HexabitzPlatform/H17R1x-Hardware/README.md

# H17R1x-Hardware
Hexabitz 10A(RMS)/85V Stepper Drive Module Hardware Design
