HexabitzPlatform/H17R1x-Hardware/H17R10/Released/BOM/H17R10.xlsx

 |  | www.hexabitz.com info@hexabitz.com |  |  | Bill Of Materials
Customer | Hexabitz | Revision | 0
Project | Hexabitz Modules | Date | 2023-05-09
Board | Stepper motor driver Module (H17R10) | Notes
Designator | Description | Manufacturer Part Number | Manufacturer | Octopart Url | Quantity
A, B, PWR | Block, Terminal; 13.5 A; 250 V; 5 mm; 26 to 16 AWG; 2; Screw; Solder; 4 kV; PA | Phoenix Contact | 1729018 | https://octopart.com/1729018-phoenix+contact-8551?r=sp | 3
R | PCB Header, Unshrouded, Thru 02 Straight Header, .101, AMPMODU Mod II Series | 87227-1 | TE Connectivity | https://octopart.com/87227-1-te+connectivity-39512052?r=sp | 1
SWD | Conn Unshrouded Header HDR 3 POS 2.54mm Solder ST Top Entry Thru-Hole Carton | 5-146281-3 | TE Connectivity | https://octopart.com/5-146281-3-te+connectivity+%2F+amp-39745942?r=sp | 1
EMG_SW | 2 Position Total Single Row 2.54 mm Pitch Straight Male Thru-Hole Header | M20-9990245 | HARWIN INC | https://octopart.com/m20-9990245-harwin-7492269?r=sp | 1
R1 | RES SMD 0.0OHM JUMPER 1/10W 0603 | RC0603JR-070RL | YAGEO [VR] | https://octopart.com/rc0603jr-070rl-yageo-1241539?r=sp | 1
R4, R6, R19, R20, R21, R22 | RES 0.1 OHM 1% 2W 2512 | PE2512FKE7W0R1L | YAGEO | https://octopart.com/pe2512fke7w0r1l-yageo-71384148?r=sp | 6
R2 | Thick Film Resistors - SMD 0603 270 Ohm 5% Tol | ERJ-3GEYJ271V | Panasonic | https://octopart.com/erj-3geyj271v-panasonic-55560546?r=sp | 1
R11, R15 | RES 330 OHM 5% 1/10W 0603 | RC0603JR-07330RL | YAGEO | https://octopart.com/rc0603jr-07330rl-yageo-39803615?r=sp | 2
R16 | Res Thick Film 0603 1K Ohm 5% 1/10W ±100ppm/°C | RC0603JR-071KL | YAGEO [VR] | https://octopart.com/rc0603jr-071kl-yageo-55402888?r=sp | 1
R18 | RES SMD 2K OHM 1% 1/10W 0603 | CRCW06032K00FKEA | Vishay Dale | https://octopart.com/crcw06032k00fkea-vishay-39455515?r=sp | 1
R3 | RES 10K Ohm 5% 0603 | CRCW060310K0JNEB | Vishay | https://octopart.com/crcw060310k0jneb-vishay-46603269 | 1
R7, R8, R9, R10 | RES 10K OHM 1% 1/8W 0805 | RC0805FR-0710KL | Panasonic | https://octopart.com/rc0805fr-0710kl-yageo-40301103?r=sp | 4
R5, R13, R14 | RES 39K OHM 1% 1/10W 0603 | RC0603FR-0739KL | Yageo | https://octopart.com/rc0603fr-0739kl-yageo-55402883?r=sp | 3
R17 | RES SMD 100K OHM 1% 1/10W 0603 | CRCW0603100KFKEA | Vishay Dale | https://octopart.com/crcw0603100kfkea-vishay-39670900?r=sp | 1
C15 | CAP CER 0.047UF 100V X7R 0805 | C0805C473K1RACTU | KEMET | https://octopart.com/c0805c473k1ractu-kemet-12557765?r=sp | 1
C1 ,C2, C4, C6, C8,C16, C17,C22 ,C23 | CAP CER 0.1 UF 10% X7R 0603 | C0603C104K8RACTU | KEMET | https://octopart.com/c0603c104k8ractu-kemet-145075?r=sp&s=9bS9ASSwSEqMCE9KBEQZ0g | 9
C11, C12, C13, C14 | CAP CER 0.22UF 100V X7R 0805 | C0805C224K1RAC7800 | KEMET | https://octopart.com/c0805c224k1ractu-kemet-12818106?r=sp | 4
C19 | CAP CER 0.22UF 16V X7R 0603 | CC0603KRX7R7BB224 | Yageo | https://octopart.com/cc0603krx7r7bb224-yageo-6827757?r=sp | 1
C18 , C20 | CAP CER 0.47UF 16V X5R 0603 | C1608X5R1C474K080AA | TDK CORPORATION | https://octopart.com/c1608x5r1c474k080aa-tdk-25947642?r=sp | 2
C5 | CAP CER 1 UF 16V X7R 0805 | CC0805KKX7R7BB105 | YAGEO [VA] | https://octopart.com/cc0805kkx7r7bb105-yageo-8376555?r=sp | 1
C7 , C3 | CAP TANT 4.7 UF 10V 20% 0805 | 10TPU4R7MSI | Panasonic | https://octopart.com/10tpu4r7msi-panasonic-29487748?r=sp | 2
C21 | CAP TANT 22UF 10% 6.3V 1206 | T491A226K006AT | KEMET | https://octopart.com/t491a226k006at-kemet-968601?r=sp | 1
C9 , C10 | CAP ALUM 68UF 20% 100V SMD | EMVY101ARA680MKE0S | United Chemi-Con | https://octopart.com/emvy101ara680mke0s-united+chemi-con-205274?r=sp | 2
FB1 | Ind chip Bead Multi-Layer 30 ohms 25% 100MHZ Ferrite 1,5A 0603Punched paper T/R | MMZ1608Y300BTA00 | TDK | https://octopart.com/mmz1608y300bta00-tdk-7906990?r=sp | 1
D1 , D8 | Red 0603 130° Clear 54 mcd 2 V Surface Mount ChipLED | VLMS1300-GS08 | Vishay | https://octopart.com/vlms1300-gs08-vishay-21709201?r=sp&s=0nXJNjGsSbWwqfqWlZv0EA | 2
D3, D5, D6, D7, D10 | LED Uni-Color Yellow 588nm 2-Pin Chip 0603(1608Metric) T/R | VLMY1300-GS08 | VISHAY | https://octopart.com/vlmy1300-gs08-vishay-21709204?r=sp | 5
D4 | DIODE ARRAY SCHOTTKY 30V SOT23-3 | BAT54SLT1G | ONSEMI | https://octopart.com/bat54slt1g-onsemi-21401?r=sp | 1
D2 | DIODE SCHOTTKY 100V 150MA SOD123 | BAT46ZFILM | STMicroelectronics | https://octopart.com/bat46zfilm-stmicroelectronics-658190?r=sp | 1
U1 | MCU 32-Bit ARM Cortex-M0+ RISC 512kByte Flash 1.7V to 3.6V 48-Pin UFQFPN Tray | STM32G0B1CEU6N | STMicroelectronics | https://octopart.com/stm32g0b1ceu6n-stmicroelectronics-116364672?r=sp | 1
U2 | Bipolar Stepper Motor Driver 7.5V to 85V 11-Pin VFQFPN Tray | POWERSTEP01 | STMicroelectronics | https://octopart.com/powerstep01-stmicroelectronics-30554993?r=sp | 1
X1 | 8,0000MHZ 33pF SMD MURATA Resonators | CSTNE8M00G550000R0 | Murata | https://octopart.com/cstne8m00g550000r0-murata-91406934?r=sp | 1
