HexabitzPlatform/H17R1x-Hardware/H17R10/documentation/H17R10.pdf

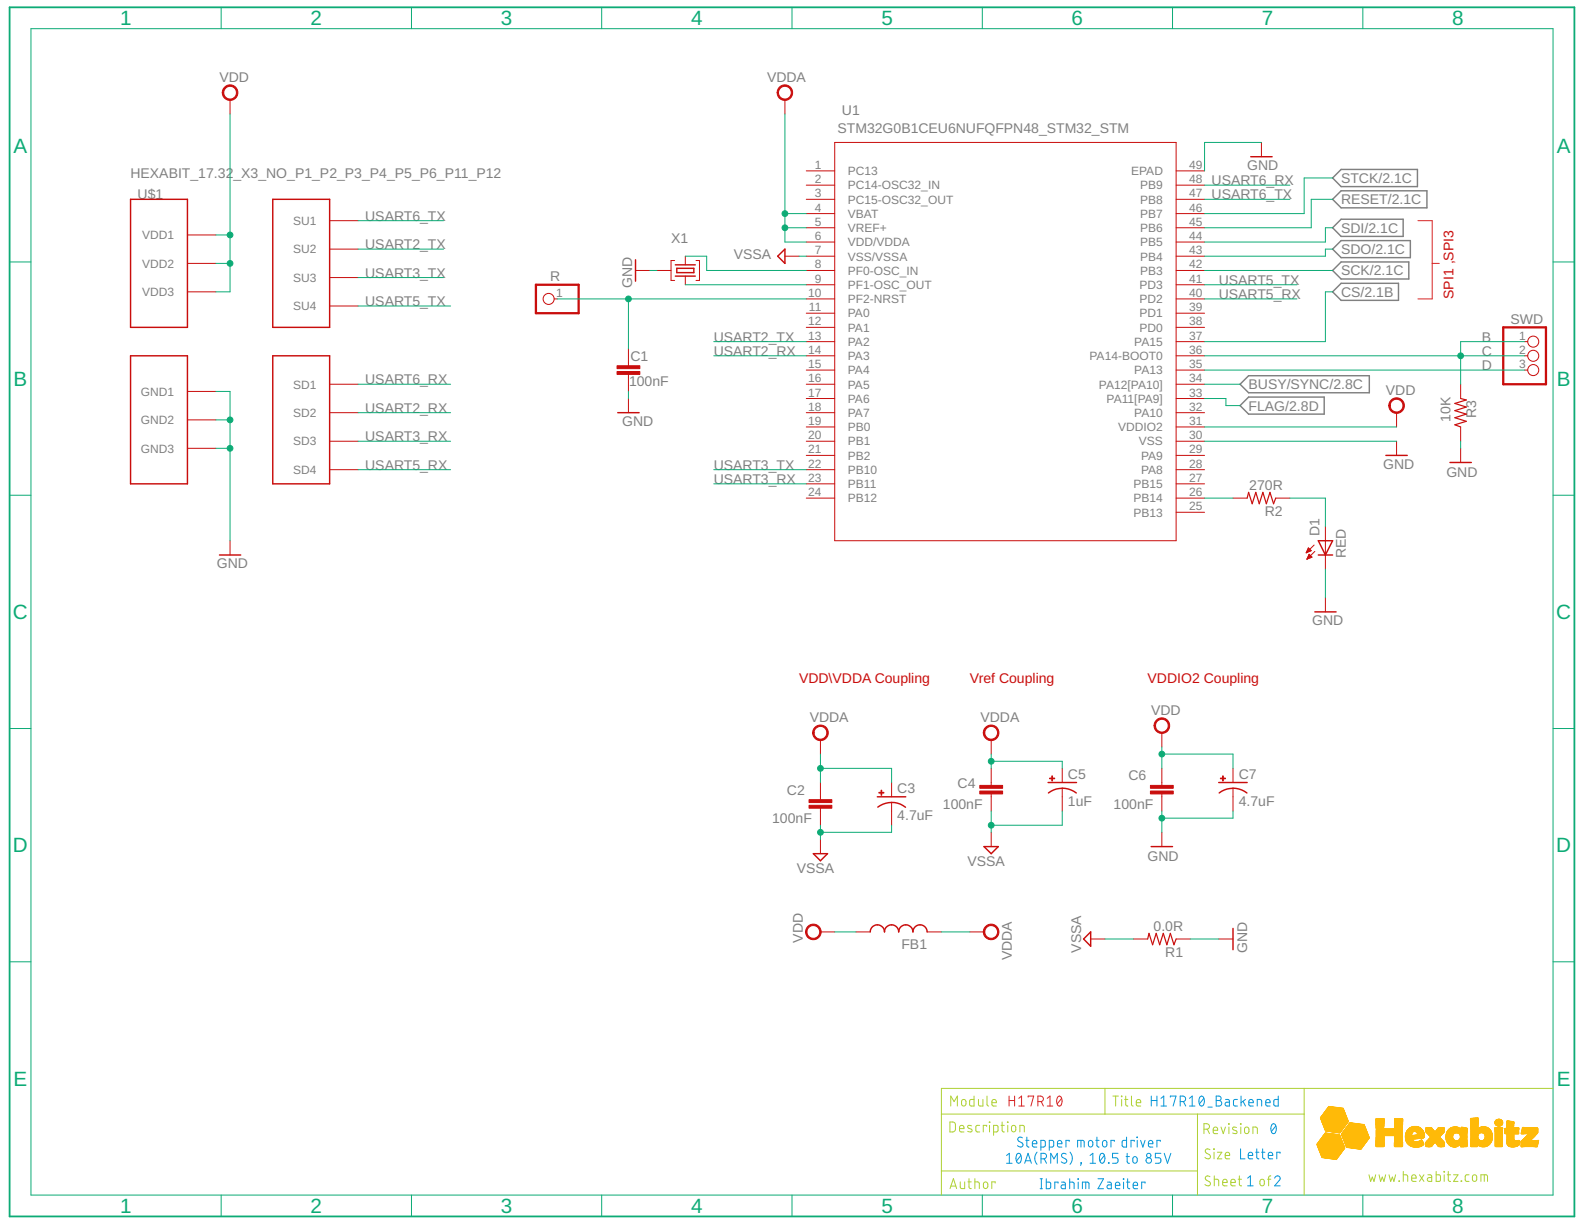
[picture p1: page 1]

VDDA

5 | | 45 PB7
6 | | 44 PB6

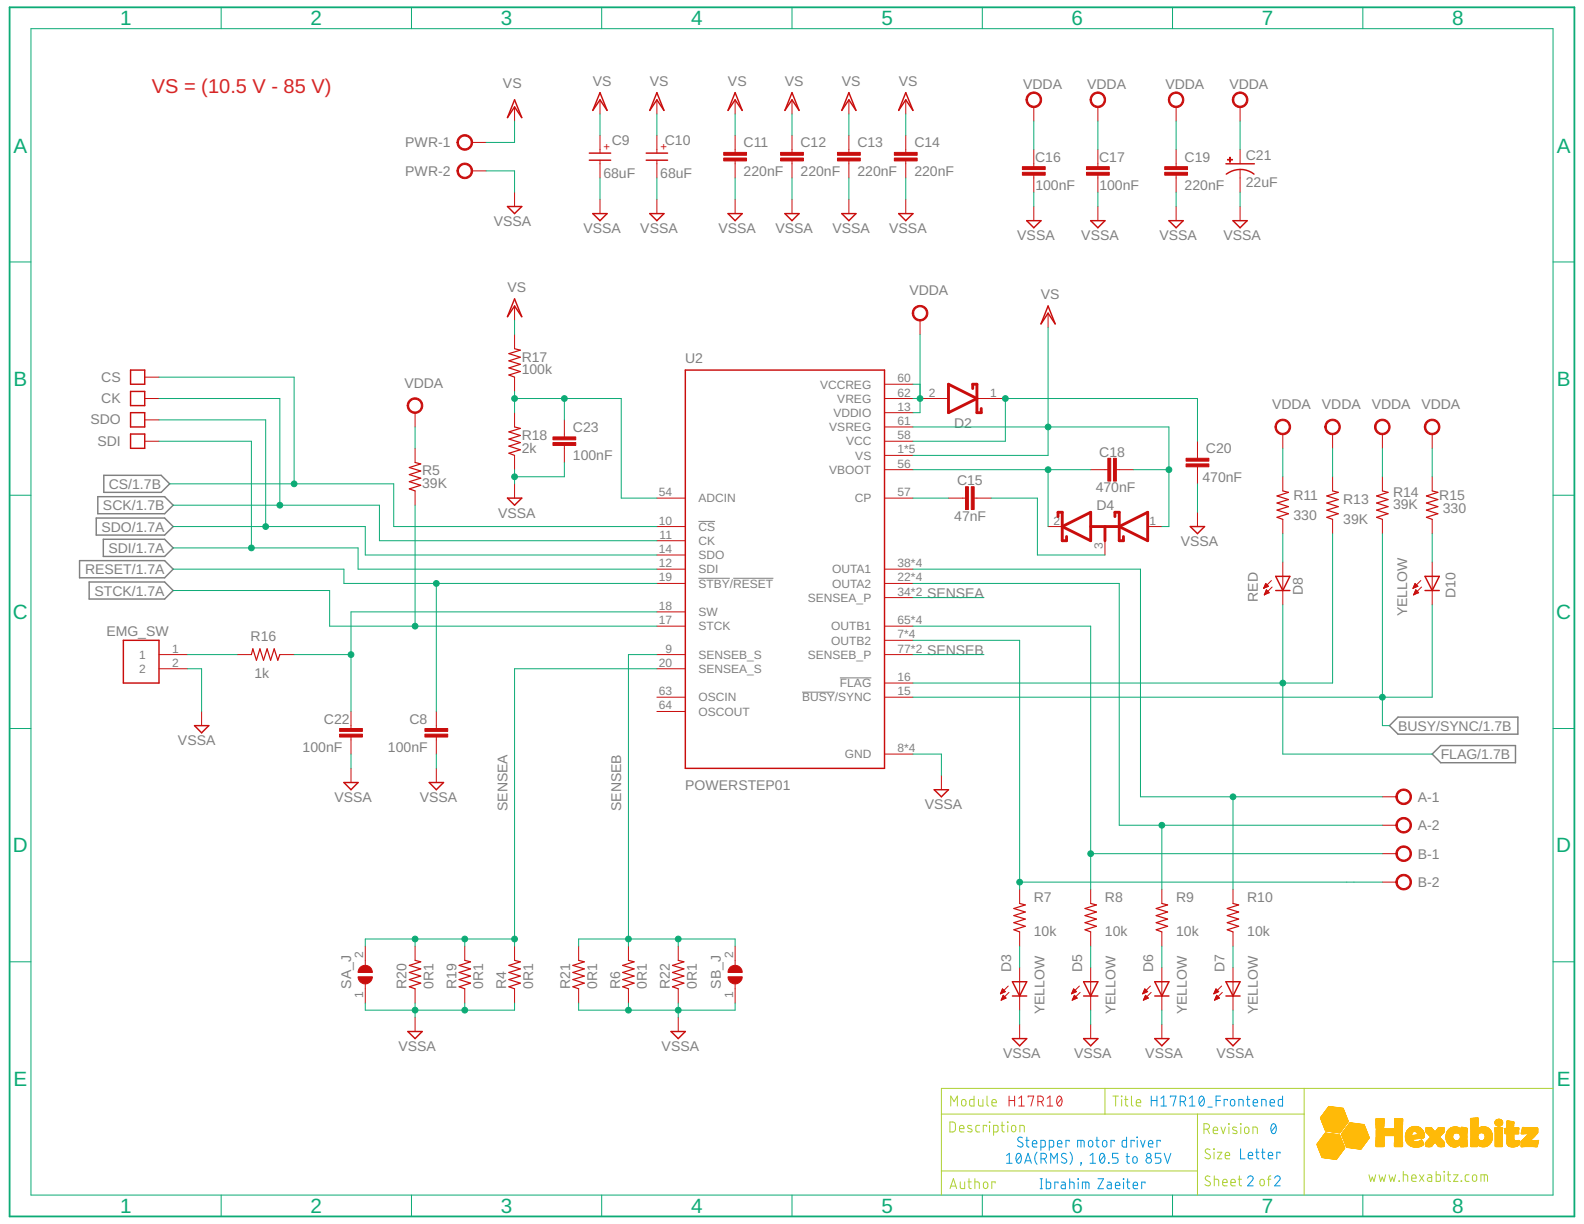
[picture p2: page 2]

VDDA VDDA
