HexabitzPlatform/H17R1x-Hardware/H17R10/design/H17R10.brd

## EAGLE design H17R10/design/H17R10.brd (2023-09-16)

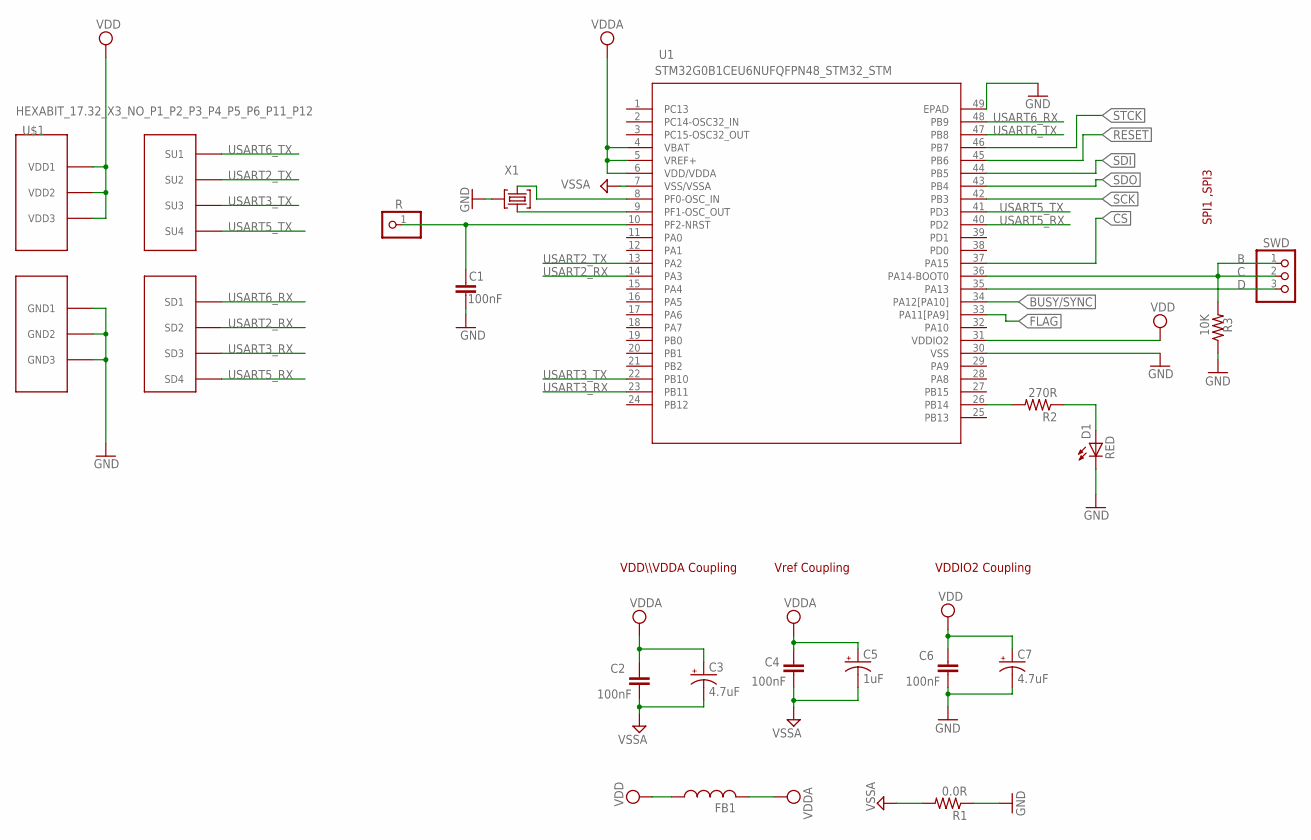
[picture p3: schematic H17R10.sch, sheet 1, I/O parts]

Parts:
C1: 100nF; C-0603; TOLERANCE 10%; VOLTAGE_RATING 16.0 V; MPN 0603YC104K4T2A
C2, C4, C6: 100nF; C-0603; TOLERANCE 10%; VOLTAGE_RATING 16.0 V; MPN '0603YC104K4T2A
C3: 4.7uF; C-0805-POL; TOLERANCE 20%; VOLTAGE_RATING 10.0 V; MPN '10TPU4R7MSI
C5: 1uF; C-0805-POL; TOLERANCE 20%; VOLTAGE_RATING 10.0 V; MPN 'CC0805KKX7R7BB105
C7: 4.7uF; C-0805-POL; TOLERANCE 10%; VOLTAGE_RATING 16.0 V; MPN '10TPU4R7MSI
D1: RED; VLMS1300-GS08
FB1: FB-TDK_MMZ1608Y300B; MPN MMZ1608Y300BTA00
R: PINHD-1X1; 1X01
R1: 0.0R; R-0603; MPN RC0603JR-070RL
R2: 270R; R-0603; MPN 'ERJ-3GEYJ271V
R3: 10K; R-0603; MPN '060300J0103T5E
SWD: PINHD-1X3; 1X03
U1: STM32G0B1CEU6NUFQFPN48_STM32_STM; HEXABITZ_ICS_UFQFPN48_STM32_STM
U$1: HEXABIT_17.32_X3_NO_P1_P2_P3_P4_P5_P6_P11_P12
X1: 8MHZ; XTALL_CSTCE8M00G52; MPN CSTNE8M00G550000R0

Connections:
BUSY/SYNC: U1.34 (PA12[PA10]); also elsewhere on the board
C: R3.2, SWD.1, SWD.2, U1.36 (PA14-BOOT0)
CS: U1.37 (PA15); also elsewhere on the board
D: SWD.3, U1.35 (PA13)
FLAG: U1.33 (PA11[PA9]); also elsewhere on the board
GND: C1.1, C6.1, C7.2 (-), D1.C, R1.1, R3.1, U1.30 (VSS), U1.49 (EPAD), U$1.PAD_PD12 (GND1), U$1.PAD_PD17 (GND2), U$1.PAD_PD19 (GND3), X1.P$2 (2)
unnamed: U1.8 (PF0-OSC_IN), X1.P$1 (1)
unnamed: U1.9 (PF1-OSC_OUT), X1.P$3 (3)
unnamed: C1.2, R.1, U1.10 (PF2-NRST)
unnamed: R2.2, U1.26 (PB14)
unnamed: D1.A, R2.1
RESET: U1.45 (PB6); also elsewhere on the board
SCK: U1.42 (PB3); also elsewhere on the board
SDI: U1.44 (PB5); also elsewhere on the board
SDO: U1.43 (PB4); also elsewhere on the board
STCK: U1.46 (PB7); also elsewhere on the board
USART2_RX: U1.14 (PA3), U$1.PAD_PD1 (SD2)
USART2_TX: U1.13 (PA2), U$1.PAD_PU1 (SU2)
USART3_RX: U1.23 (PB11), U$1.PAD_PD2 (SD3)
USART3_TX: U1.22 (PB10), U$1.PAD_PU2 (SU3)
USART5_RX: U1.40 (PD2), U$1.PAD_PD8 (SD4)
USART5_TX: U1.41 (PD3), U$1.PAD_PU8 (SU4)
USART6_RX: U1.48 (PB9), U$1.PAD_PD3 (SD1)
USART6_TX: U1.47 (PB8), U$1.PAD_PU3 (SU1)
VDD: C6.2, C7.1 (+), FB1.1, U1.31 (VDDIO2), U$1.PAD_PU12 (VDD1), U$1.PAD_PU17 (VDD2), U$1.PAD_PU19 (VDD3)
VDDA: C2.2, C3.1 (+), C4.2, C5.1 (+), FB1.2, U1.4 (VBAT), U1.5 (VREF+), U1.6 (VDD/VDDA); also elsewhere on the board
VSSA: C2.1, C3.2 (-), C4.1, C5.2 (-), R1.2, U1.7 (VSS/VSSA); also elsewhere on the board

Notes on the sheet:
VDDIO2 Coupling
VDD\\\VDDA Coupling
Vref Coupling
SPI1 ,SPI3

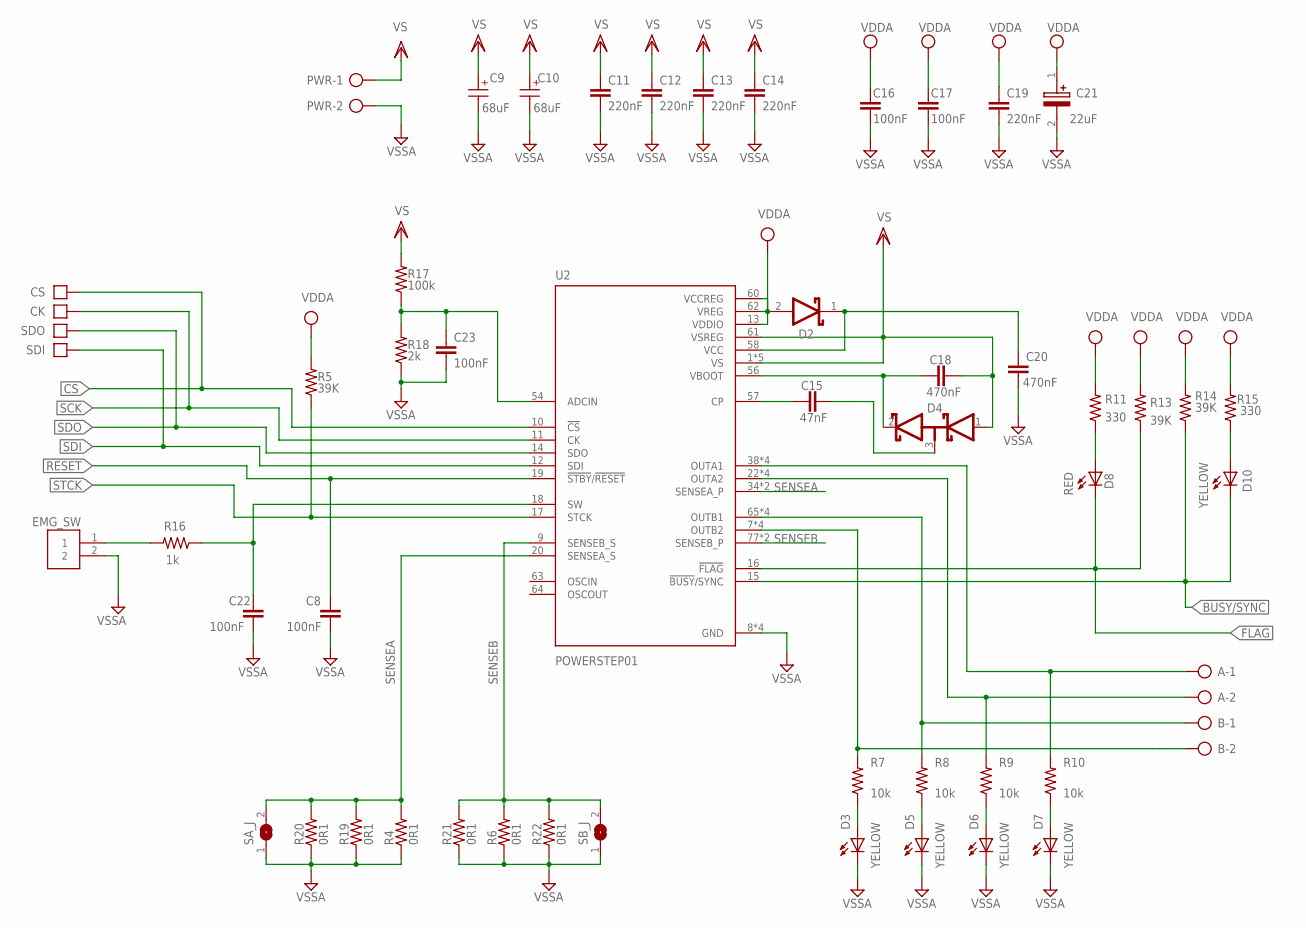
[picture p4: schematic H17R10.sch, sheet 2]

Parts:
A: AK500/2
B: AK500/2
C8, C22, C23: 100nF; C-0603; MPN C1608X7R1H104K080AA
C9, C10: 68uF; WCAP-ASLI_12.5X14(DXL)
C11, C12, C13, C14: 220nF; C-0805
C15: 47nF; C-0805; VOLTAGE_RATING 100V; MPN C0805C473K1RACTU
C16, C17: 100nF; C-0603; TOLERANCE 10%; VOLTAGE_RATING 16.0 V; MPN '0603YC104K4T2A
C18, C20: 470nF; C-0603; VOLTAGE_RATING 100V; MPN CGA3E3X7R1E474K080AE
C19: 220nF; C-0603; MPN CGA3E3X7R1V224K080AE
C21: 22uF; T491A
CK: PAD4
CS: PAD4
D2: STMICROELECTRONICS_BAT46ZFILMSTMICROELECTRONICS_B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; STMICROELECTRONICS_BAT46ZFILM_3
D3, D5, D6, D7, D10: YELLOW; VLMY1300-GS08; MPN LTST-C170YKT
D4: STMICROELECTRONICS_BAR43SFILMSTMICROELECTRONICS_B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; STMICROELECTRONICS_BAR43SFILM_0
D8: RED; VLMS1300-GS08; MPN LTST-C170-EKT
EMG_SW: 3-644456-2; TE_3-644456-2
PWR: AK500/2
R4, R6, R19, R20, R21, R22: 0R1; R2512; MPN PE2512FKE7W0R1L
R5, R13, R14: 39K; R-0603; MPN RC0603FR-0739KL
R7, R8, R9, R10: 10k; R-0805; MPN ERJ-6GEYJ103V
R11, R15: 330; R-0603; MPN RC0603JR-07330RL
R16: 1k; R-0603; MPN RC0603JR-07330RL
R17: 100k; R-0603; MPN RC0603FR-0739KL
R18: 2k; R-0603; MPN RC0603FR-0739KL
SA_J: SJW
SB_J: SJW
SDI: PAD4
SDO: PAD4
U2: POWERSTEP01; IC_POWERSTEP01

Connections:
BUSY/SYNC: D10.C, R14.1, U2.15 (!BUSY!/SYNC); also elsewhere on the board
CS: CS.P$1, U2.10 (!CS); also elsewhere on the board
FLAG: D8.C, R13.1, U2.16 (!FLAG); also elsewhere on the board
unnamed: C22.1, R16.1, U2.18 (SW)
unnamed: C15.1, U2.57 (CP)
unnamed: D10.A, R15.1
unnamed: D7.A, R10.1
unnamed: C23.1, R17.1, R18.2, U2.54 (ADCIN)
unnamed: D3.A, R7.1
unnamed: D8.A, R11.1
unnamed: D5.A, R8.1
unnamed: D6.A, R9.1
unnamed: C18.2, D4.2 (K1), U2.56 (VBOOT)
unnamed: C20.1, D2.1 (CATHODE), U2.58 (VCC)
unnamed: C15.2, D4.3 (A1/K2)
OUTA1: A.2, R10.2, U2.38 (OUTA1), U2.42 (OUTA1), U2.53 (OUTA1), U2.EPAD4 (OUTA1)
OUTA2: A.1, R9.2, U2.22 (OUTA2), U2.33 (OUTA2), U2.37 (OUTA2), U2.EPAD3 (OUTA2)
OUTB1: B.1, R8.2, U2.65 (OUTB1), U2.76 (OUTB1), U2.80 (OUTB1), U2.EPAD7 (OUTB1)
OUTB2: B.2, R7.2, U2.7 (OUTB2), U2.81 (OUTB2), U2.85 (OUTB2), U2.EPAD8 (OUTB2)
RESET: C8.1, U2.19 (!STBY!/!RESET); also elsewhere on the board
SCK: CK.P$1, U2.11 (CK); also elsewhere on the board
SDI: SDI.P$1, U2.12 (SDI); also elsewhere on the board
SDO: SDO.P$1, U2.14 (SDO); also elsewhere on the board
SENSEA: R4.2, R19.2, R20.2, SA_J.2, U2.20 (SENSEA_S), U2.34 (SENSEA_P), U2.39 (SENSEA_P)
SENSEB: R6.2, R21.2, R22.2, SB_J.2, U2.9 (SENSEB_S), U2.77 (SENSEB_P), U2.82 (SENSEB_P)
STCK: R5.1, U2.17 (STCK); also elsewhere on the board
SW: EMG_SW.1, R16.2
VDDA: C16.2, C17.2, C19.1, C21.1 (+), D2.2 (ANODE), R5.2, R11.2, R13.2, R14.2, R15.2, U2.13 (VDDIO), U2.60 (VCCREG), U2.62 (VREG); also elsewhere on the board
VS: C9.1 (+), C10.1 (+), C11.1, C12.1, C13.1, C14.1, C18.1, D4.1 (A2), PWR.1, R17.2, U2.1 (VS), U2.23 (VS), U2.43 (VS), U2.55 (VS), U2.61 (VSREG), U2.66 (VS)
VSSA: C8.2, C9.2 (-), C10.2 (-), C11.2, C12.2, C13.2, C14.2, C16.1, C17.1, C19.2, C20.2, C21.2 (-), C22.2, C23.2, D3.C, D5.C, D6.C, D7.C, EMG_SW.2, PWR.2, R4.1, R6.1, R18.1, R19.1, R20.1, R21.1, R22.1, SA_J.1, SB_J.1, U2.8 (GND), U2.21 (GND), U2.59 (GND), U2.EPAD9 (GND); also elsewhere on the board

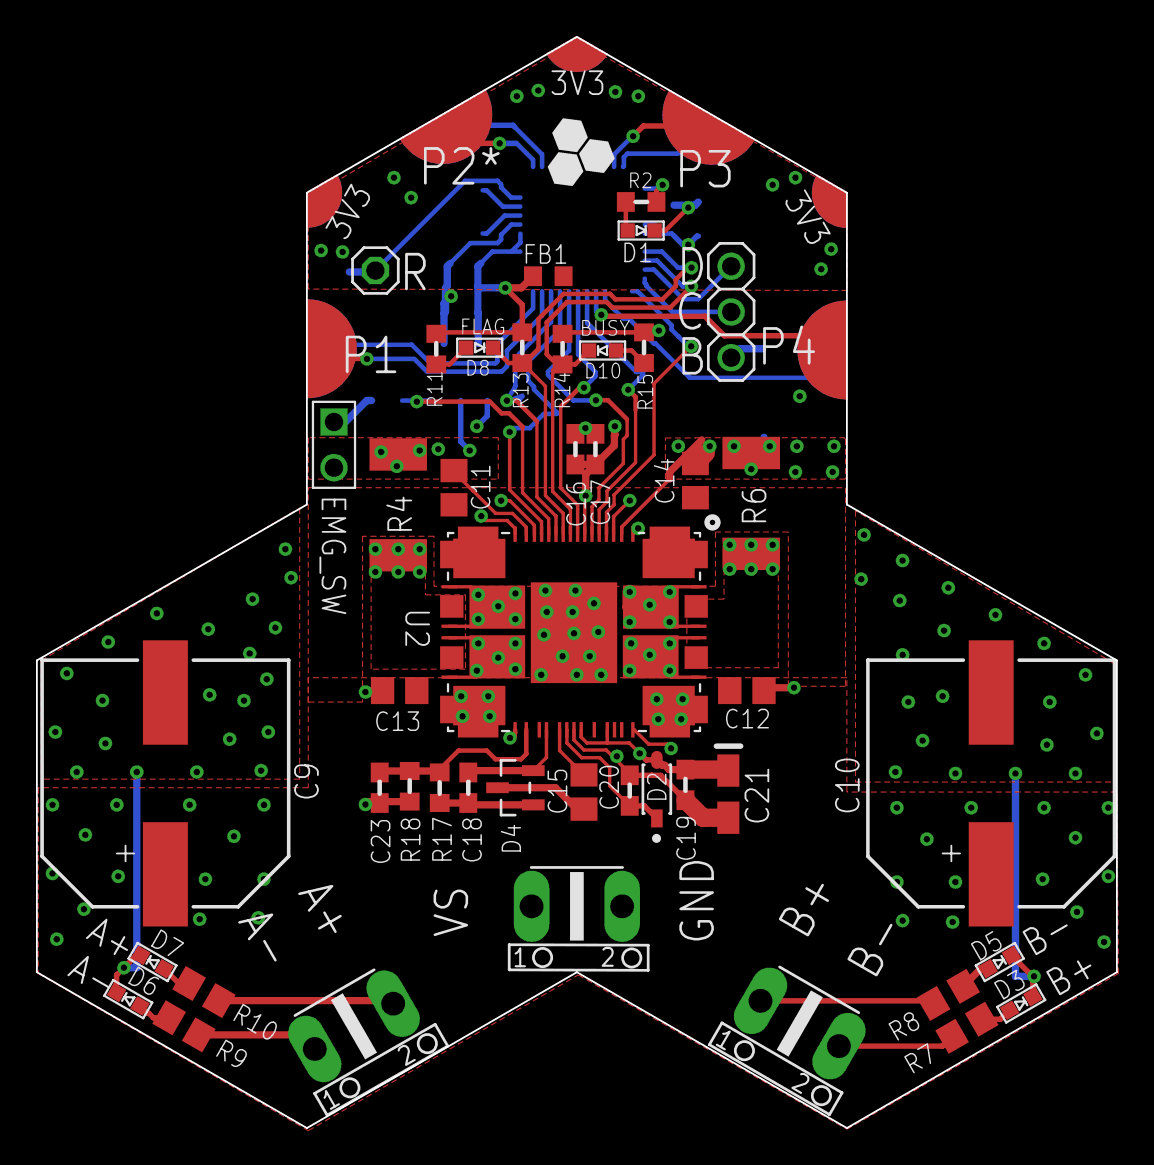
[picture p5: board H17R10.brd from above]

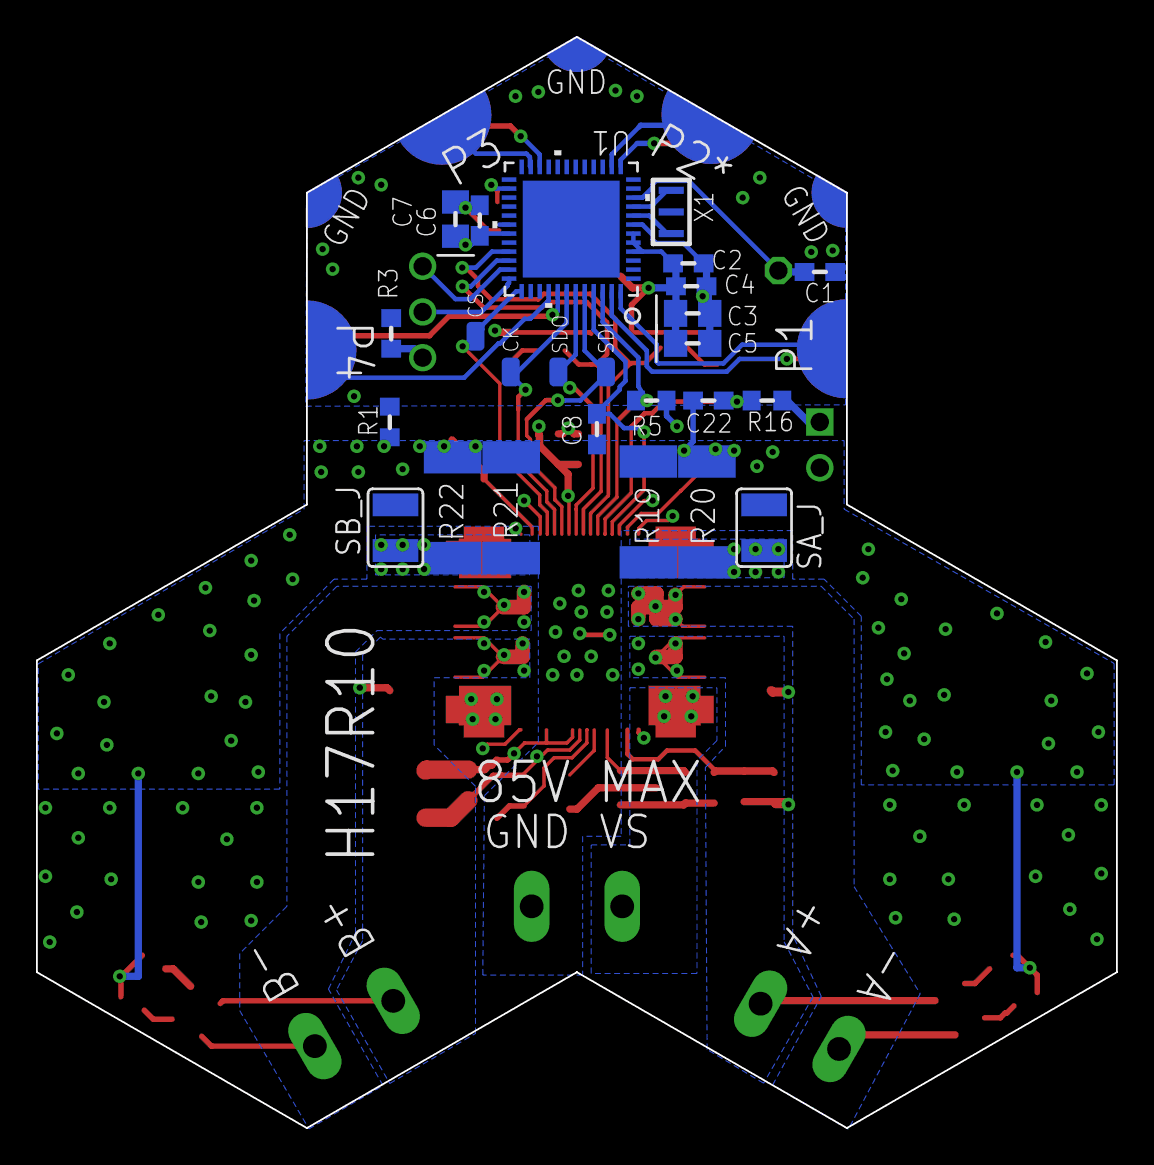
[picture p6: board H17R10.brd from below]

Board: 4 copper layers, 60.0 x 60.6 mm, 70 parts (25 on the bottom side), 47 nets.
