HexabitzPlatform/H17R1x-Hardware/(commit log)

2021-03-25 finished schematics refrenced by ST module & adding isolation
    [H17R10.brd, H17R10.sch]
2021-03-25 R24 added
    [H17R10.brd, H17R10.sch]
2021-04-03 finished board >>> unchecked
    [H17R10.brd, H17R10.sch]
2021-04-19 final with output files
    [H17R10.brd, H17R10.sch, H17R10.xlsx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]
2021-04-22 - Updated BOM..
    [H17R10.xlsx]
2022-11-28 -Changing the MCU to STM32G0B1CEU6N -Editing the electronic design -Editing the layout design to improve the performance
    [H17R10.brd, H17R10.sch, H17R10.xlsx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]
2022-11-29 -Adding some components to the design to improve the performance
    [H17R10.brd, H17R10.sch, H17R10.xlsx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]
2022-11-29 -Editing in the layout design
    [H17R10.brd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]
2022-12-28 -Replace the blind vias with through hole ones
    [H17R10.brd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]
2023-02-15 -Correcting some documentation issues
    [H17R10.xlsx]
2023-09-16 -Connect missing wires - Delete power led - Improve the layout for better performance and appearance
    [H17R10.brd, H17R10.sch, H17R10.xlsx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]
